ilyas9461/tv_yakin/foto/5157.jpg

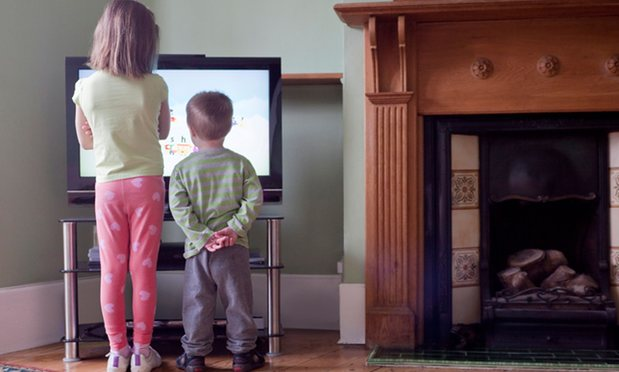
foto/5157.jpg
