ilyas9461/tv_yakin/foto/devre_ve_sensor_son.jpg

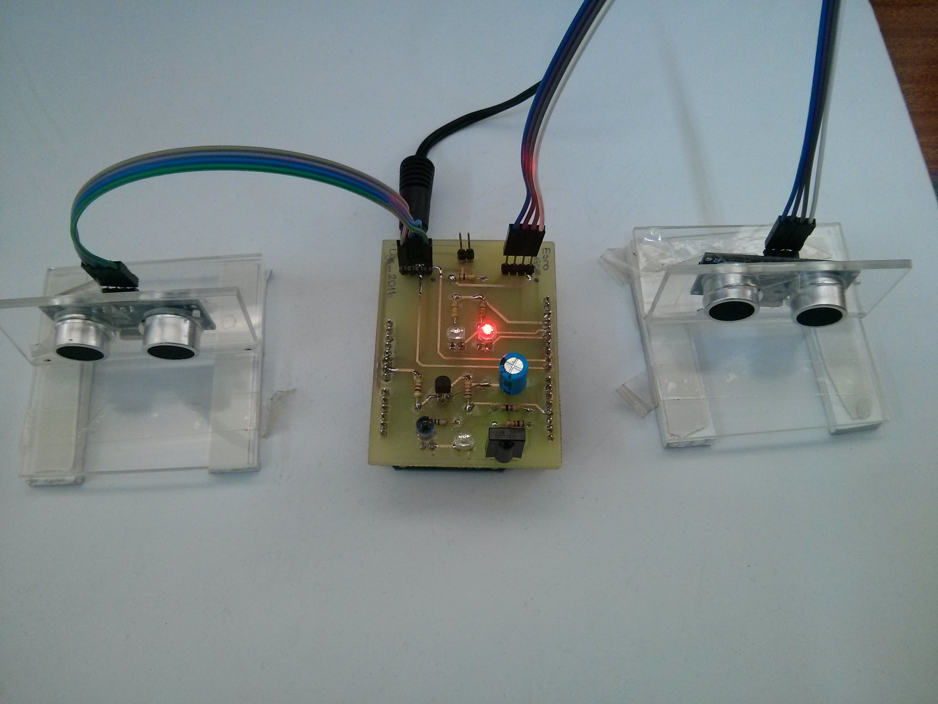
foto/devre_ve_sensor_son.jpg
