ilyas9461/tv_yakin/foto/tv_yakin_pcb.png

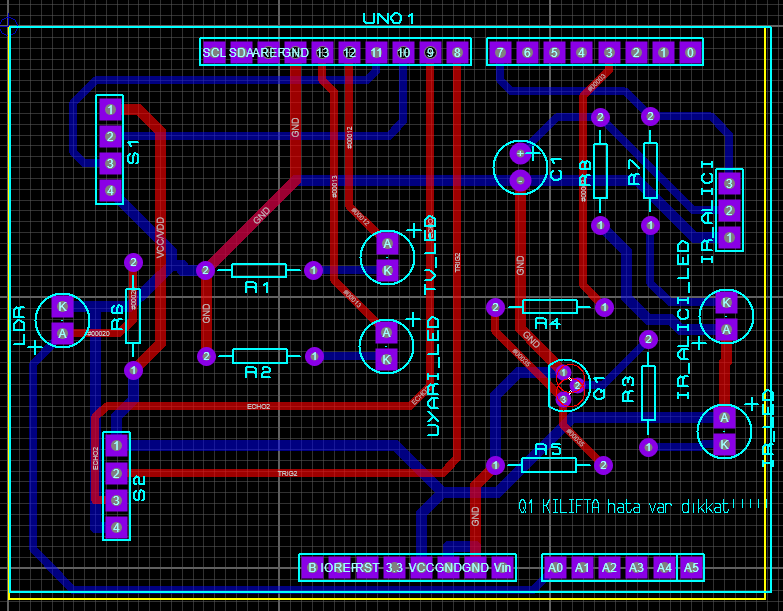
foto/tv_yakin_pcb.png
