ilyas9461/tv_yakin/foto/tv_yakin_sema.png

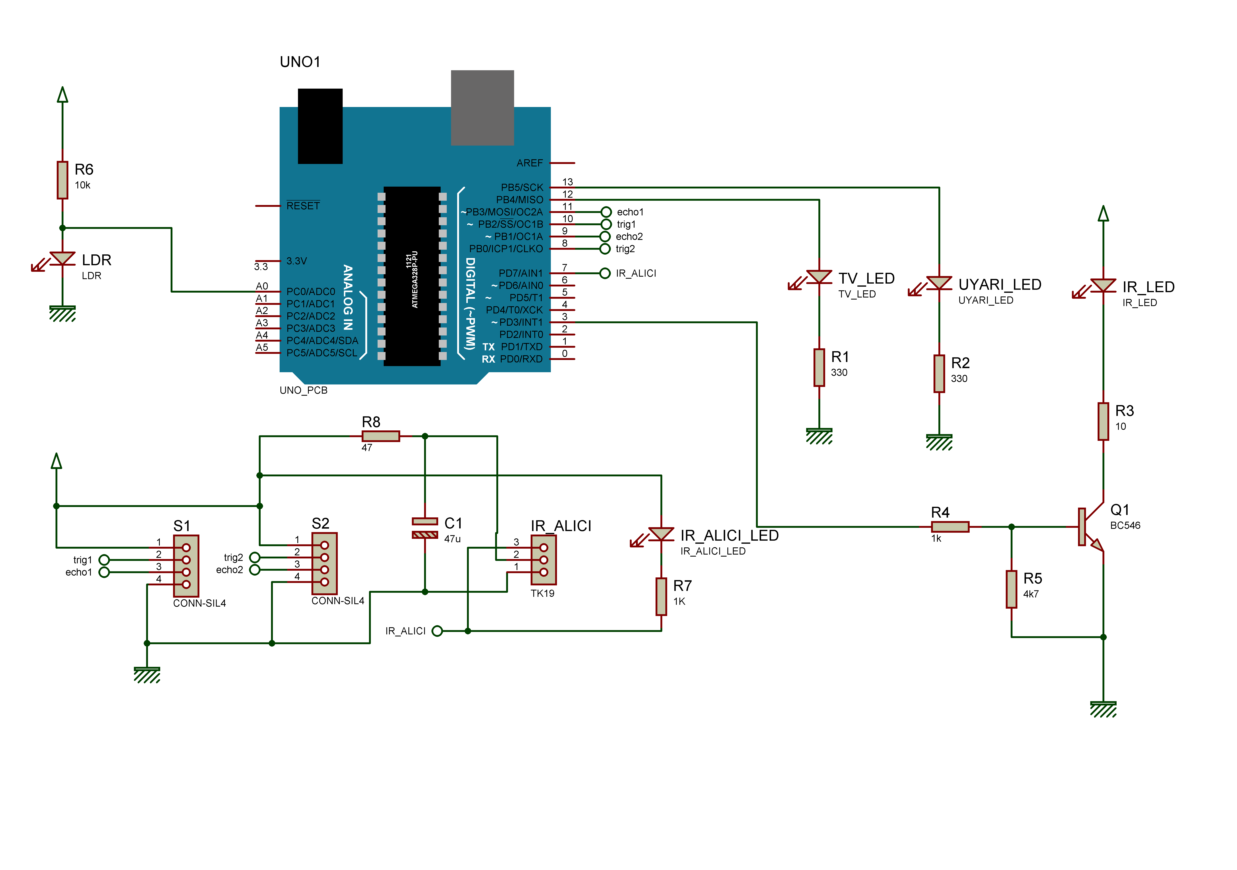
foto/tv_yakin_sema.png
