ilyas9461/tv_yakin/foto/TVYakın_MF_Ac.jpg

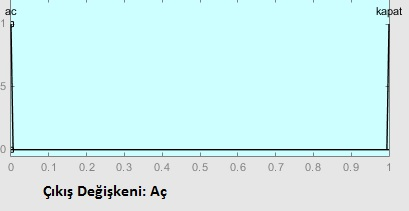
foto/TVYakın_MF_Ac.jpg
