ilyas9461/tv_yakin/foto/TVYakın_MF_S1.jpg

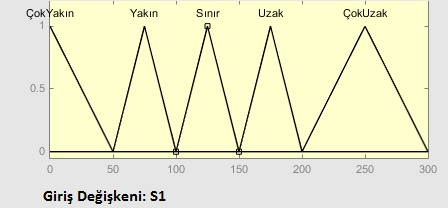
foto/TVYakın_MF_S1.jpg
