ilyas9461/tv_yakin/foto/TVYakın_MF_S2.jpg

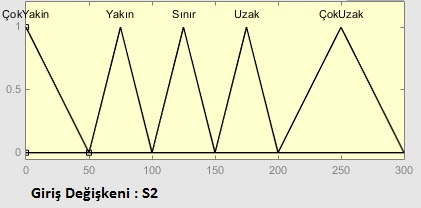
foto/TVYakın_MF_S2.jpg
