ilyas9461/tv_yakin/foto/TVYakın_MF_Z1.jpg

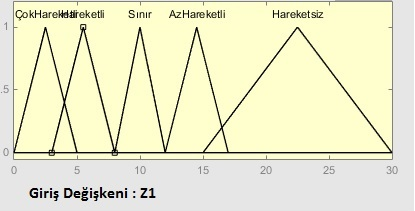
foto/TVYakın_MF_Z1.jpg
